Autofabricantes/MYO_ESPControlBoard/02_Elements/MYO_ESPControlBoard_Rev_1/02_HW/eagleUp/eagleUp_MYO_ESPControlBoard_Rev_1_board_bottom.png

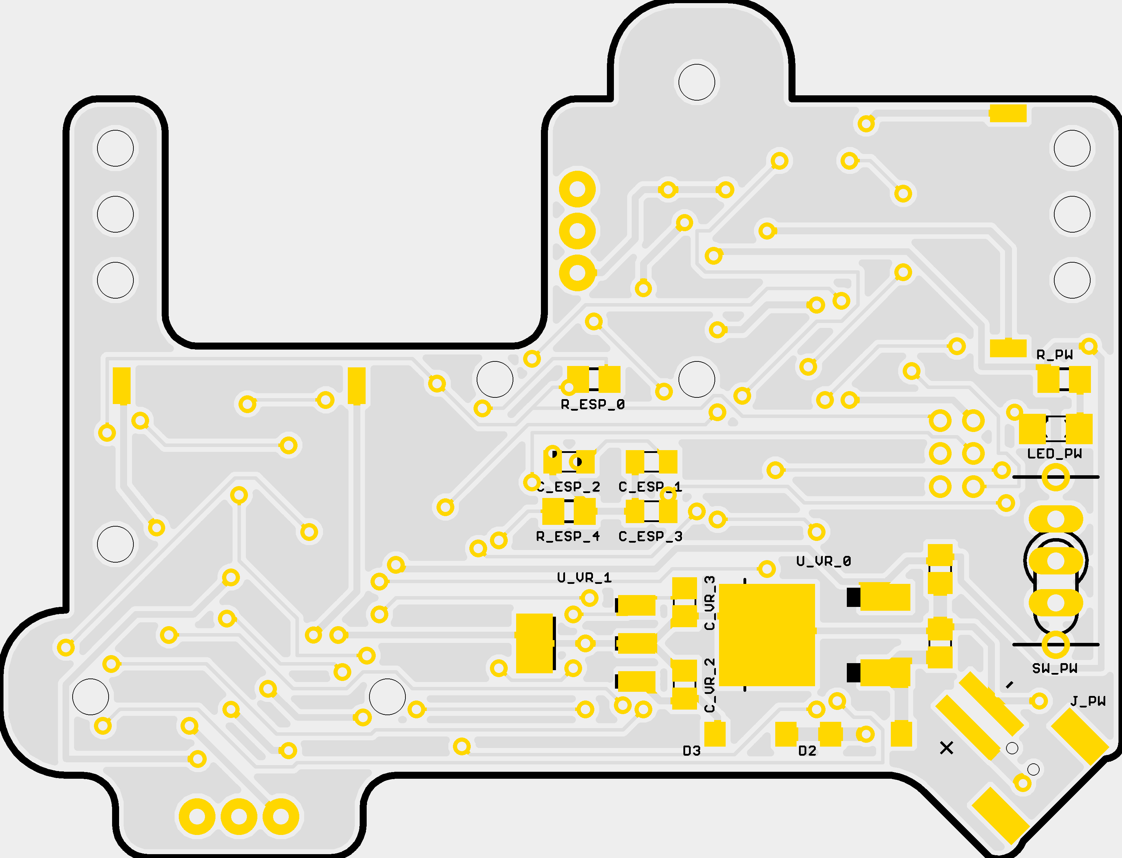
02_Elements/MYO_ESPControlBoard_Rev_1/02_HW/eagleUp/eagleUp_MYO_ESPControlBoard_Rev_1_board_bottom.png
