Autofabricantes/MYO_ESPControlBoard/00_Documentation/Arduino_ESP12F_Tutorial_00.png

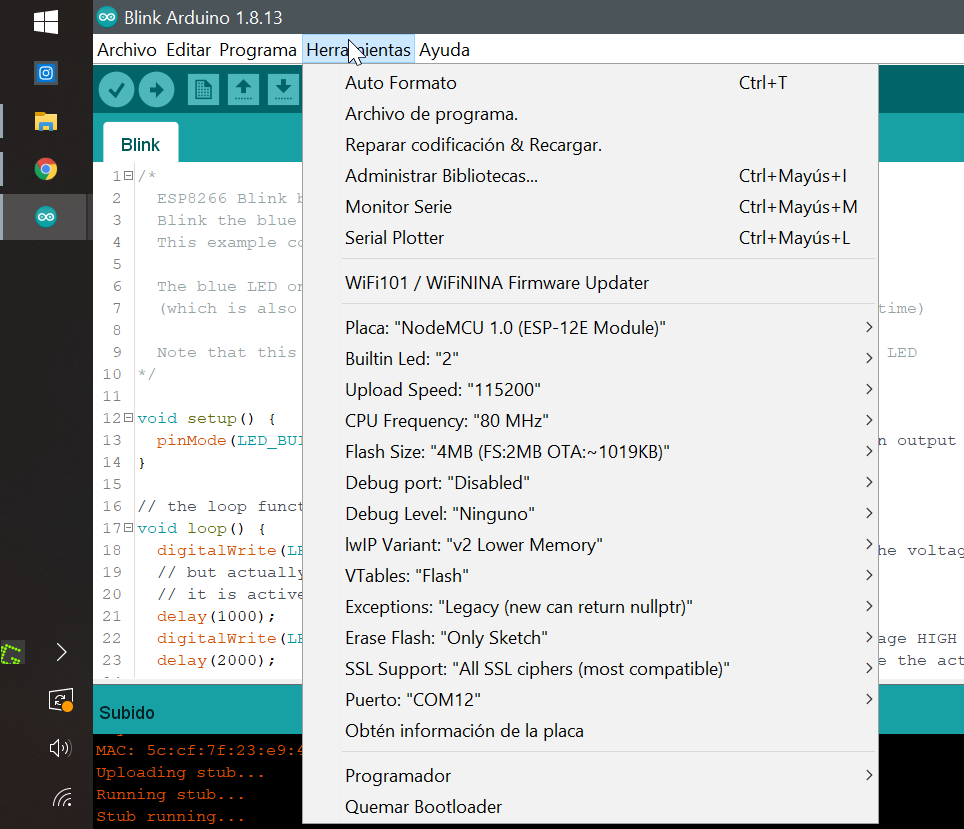
00_Documentation/Arduino_ESP12F_Tutorial_00.png
