Autofabricantes/MYO_ESPControlBoard/02_Elements/MYO_ESPControlBoard_Rev_1/00_Documentation/MYO_ESPControlBoard_Rev_1_Schematic.pdf

# io 0 sup 0 io 0

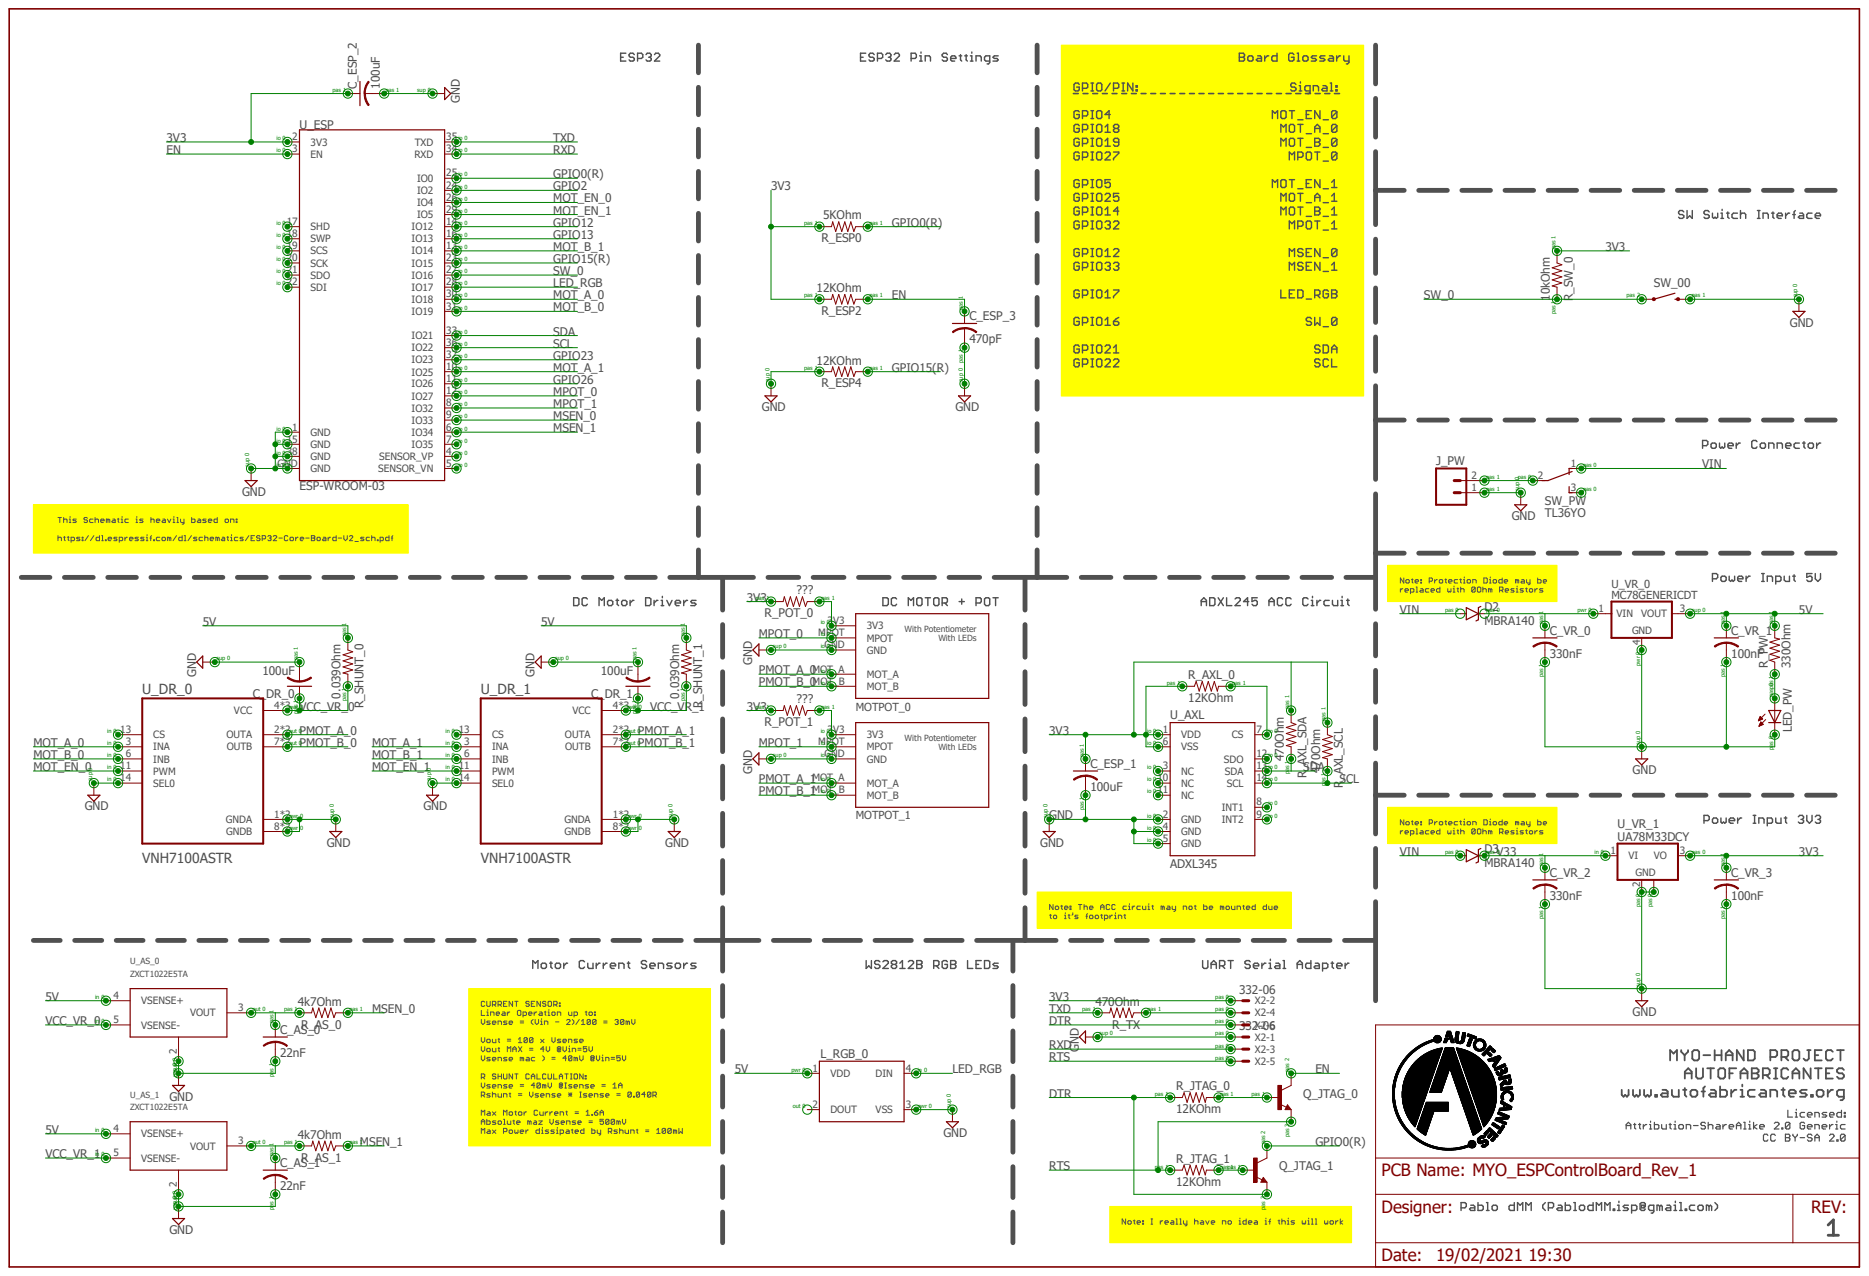
[picture p4: page 1]
330Ohm; GND; ESP-WROOM-03 GND; MC78GENERICDT GND GND; UA78M33DCY; MBRA140; 5KOhm; 12KOhm; GND ¹⁰⁰uF; 470pF GND; ADXL345; 470Ohm; GND TL36YO; VNH7100ASTR; 4k7Ohm; 22nF ZXCT1022E5TA GND; 0.039Ohm; GND ¹⁰kOhm; 332-06 GND 470Ohm; LED_PW R_PW; GND 1; SENSOR_VP; 4 SENSOR_VN; 14 GND 15; 16 SHD 17; SWP 18; SCS 19; GND 38; TXD; 35 RXD; SDI 22; SDO 21; SCK 20; GND GND; U_ESP; VIN 1 4 VOUT; 3V3 3V3 MPOT MPOT GND GND; MOT_A MOT_A MOT_B MOT_B; MOTPOT_0With Potentiometer With LEDs 3V3 3V3; MPOT MPOT GND GND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
