Autofabricantes/MYO_ESPControlBoard/00_Documentation/MYO_ESPControlBoard_Rev_1_Propuesta_01.pdf

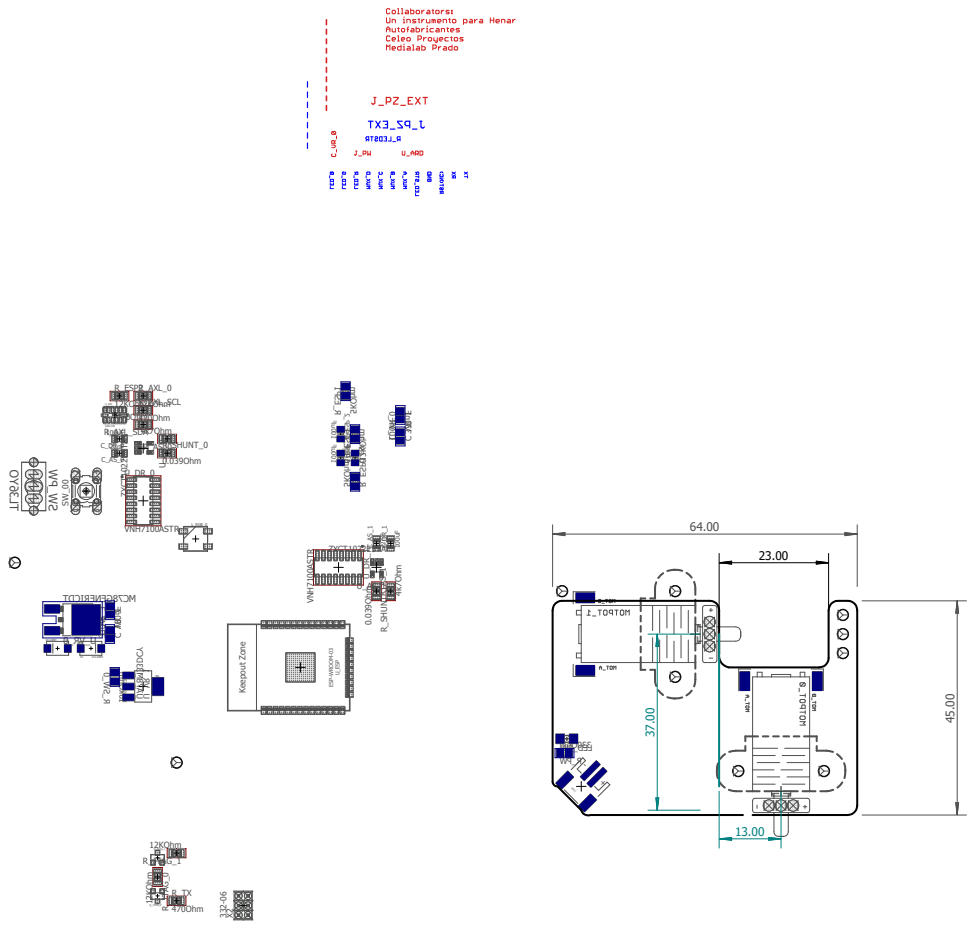
[picture p5: page 1]
R_ESP2; L_RGB_0; U_AXL R_AXL_SDA; R_AXL_SCL; R_AXL_0; U_AS_0R_SHUNT_0; R_SHUNT_1R_AS_1 C_AS_1; Q_JTAG_1; Q_JTAG_0 R_JTAG_1 R_JTAG_0; ESP⁻WROOM⁻⁰³; 12KOhm ADXL345 470Ohm470Ohm; 12KOhm; VNH7100ASTR; VNH⁷¹⁰⁰ASTR; 4k7Ohm; 22nF ZXCT1022E5TA; 0.039Ohm; 4k7Ohm ²²nF ZXCT1022E5TA; 12KOhm 12KOhm; 332⁻06 470Ohm
