Autofabricantes/MYO_ESPControlBoard/02_Elements/MYO_ESPControlBoard_Rev_1/00_Documentation/MYO_ESPControlBoard_Rev_1_Dimensions.pdf

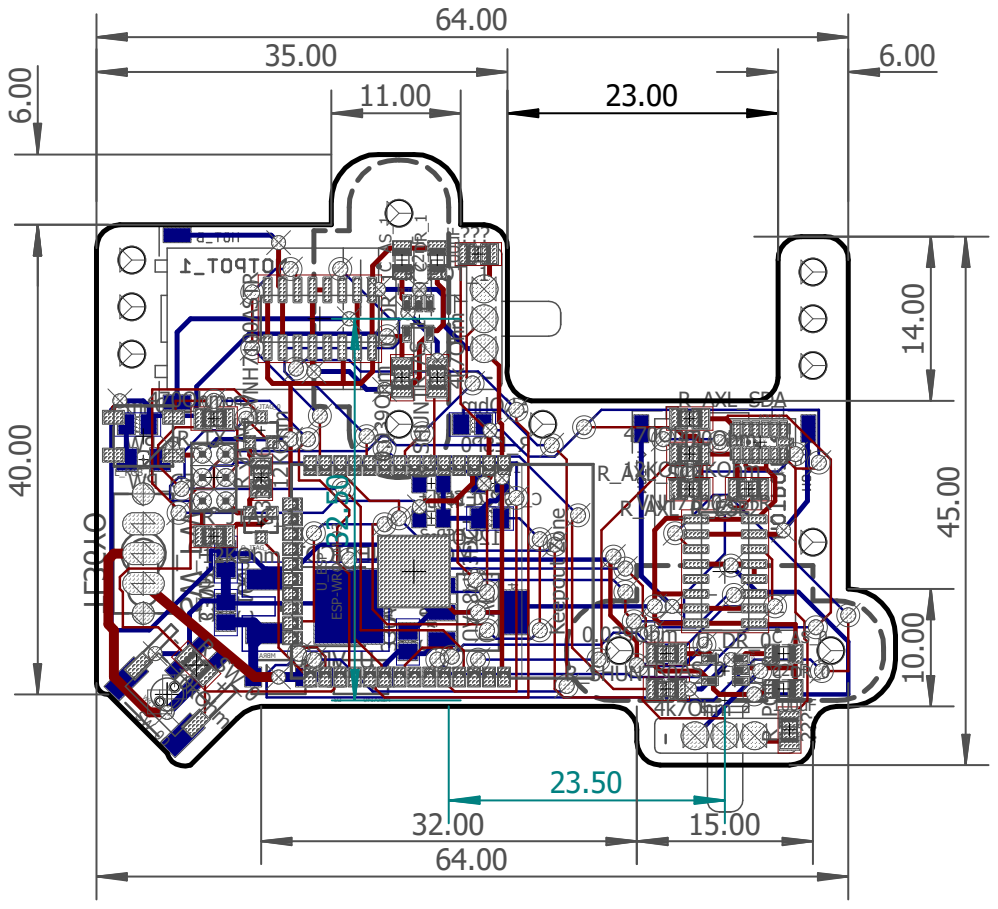
[picture p6: page 1]
1 2Keepout Zone; X Y Z U_ESP; R_ESP2; L_RGB_0; U_AXL R_AXL_SDA; R_AXL_SCL R_AXL_0; C_AS_0 R_SHUNT_0; U_AS_0 R_SHUNT_1R_AS_1 C_AS_1; Q_JTAG_1; Q_JTAG_0 R_JTAG_1 R_JTAG_0 X2R_TX; SW_00 R_POT_0; 12KOhm; ADXL345 470Ohm470Ohm; 12KOhm VNH7100ASTR; 100uF VNH⁷¹⁰⁰ASTR; 4k7Ohm; 22nF ZXCT1022E5TA; 0.039Ohm ⁰.039Ohm; 4k7Ohm ²²nF; ZXCT1022E5TA 10kOhm; 12KOhm ¹²KOhm 332⁻06; 470Ohm

R_POT_1 ESP⁻WROOM⁻⁰³
