Autofabricantes/MYO_ESPControlBoard/01_Resources/esp32-devkitc-v4_reference_design/ESP32-DevKitC-V4_Reference_Design/02_PCB Layout/ESP32-DevKitC-V4_PCB_20171206A.pdf

D1D¹x1 D¹x2 J2J2x1 J2x2 J2x3 J2x4 J2x5 J2x6 J2x7 J2x8 J2x9 J2x10 J2x11 J2x12 J2x13 J2x14 J2x15 J2x16 J2x17 J2x18 J2x19

J3J3x1 J3x2 J3x3 J3x4 J3x5 J3x6 J3x7 J3x8 J3x9 J3x10 J3x11 J3x12 J3x13 J3x14 J3x15 J3x16 J3x17 J3x18 J3x19

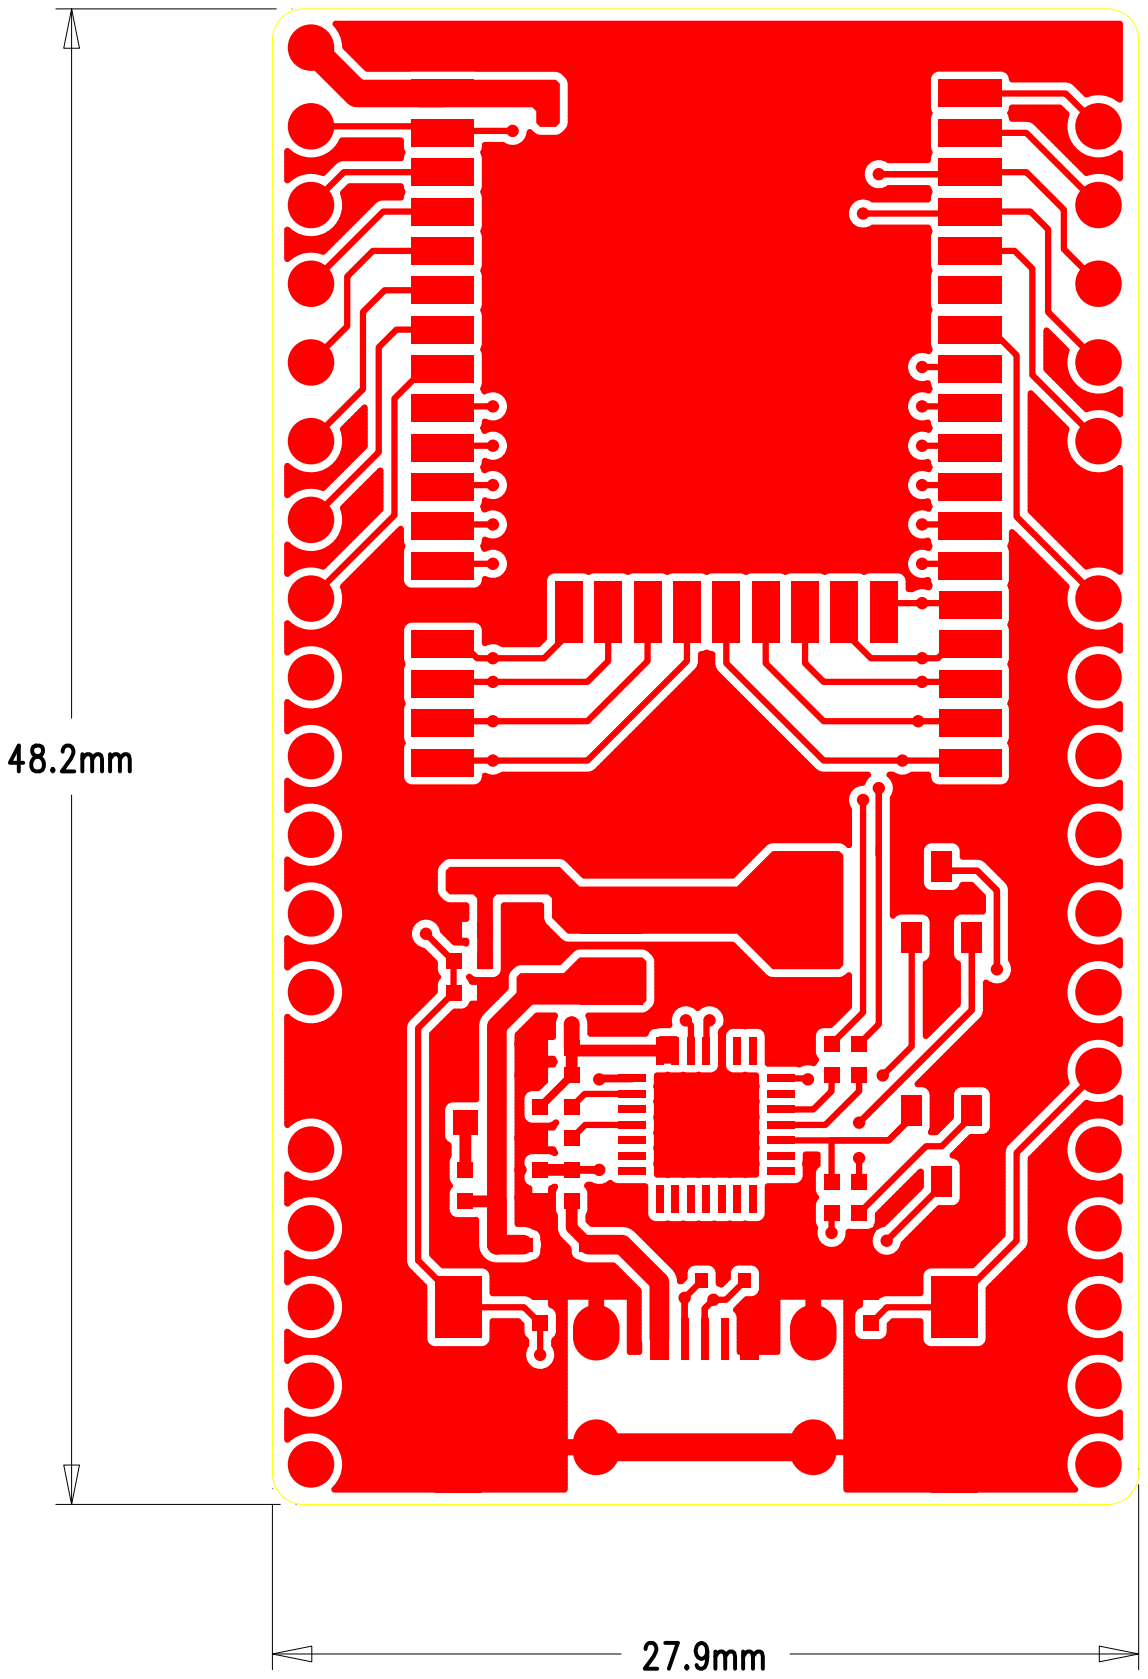
[picture p7: page 1]
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

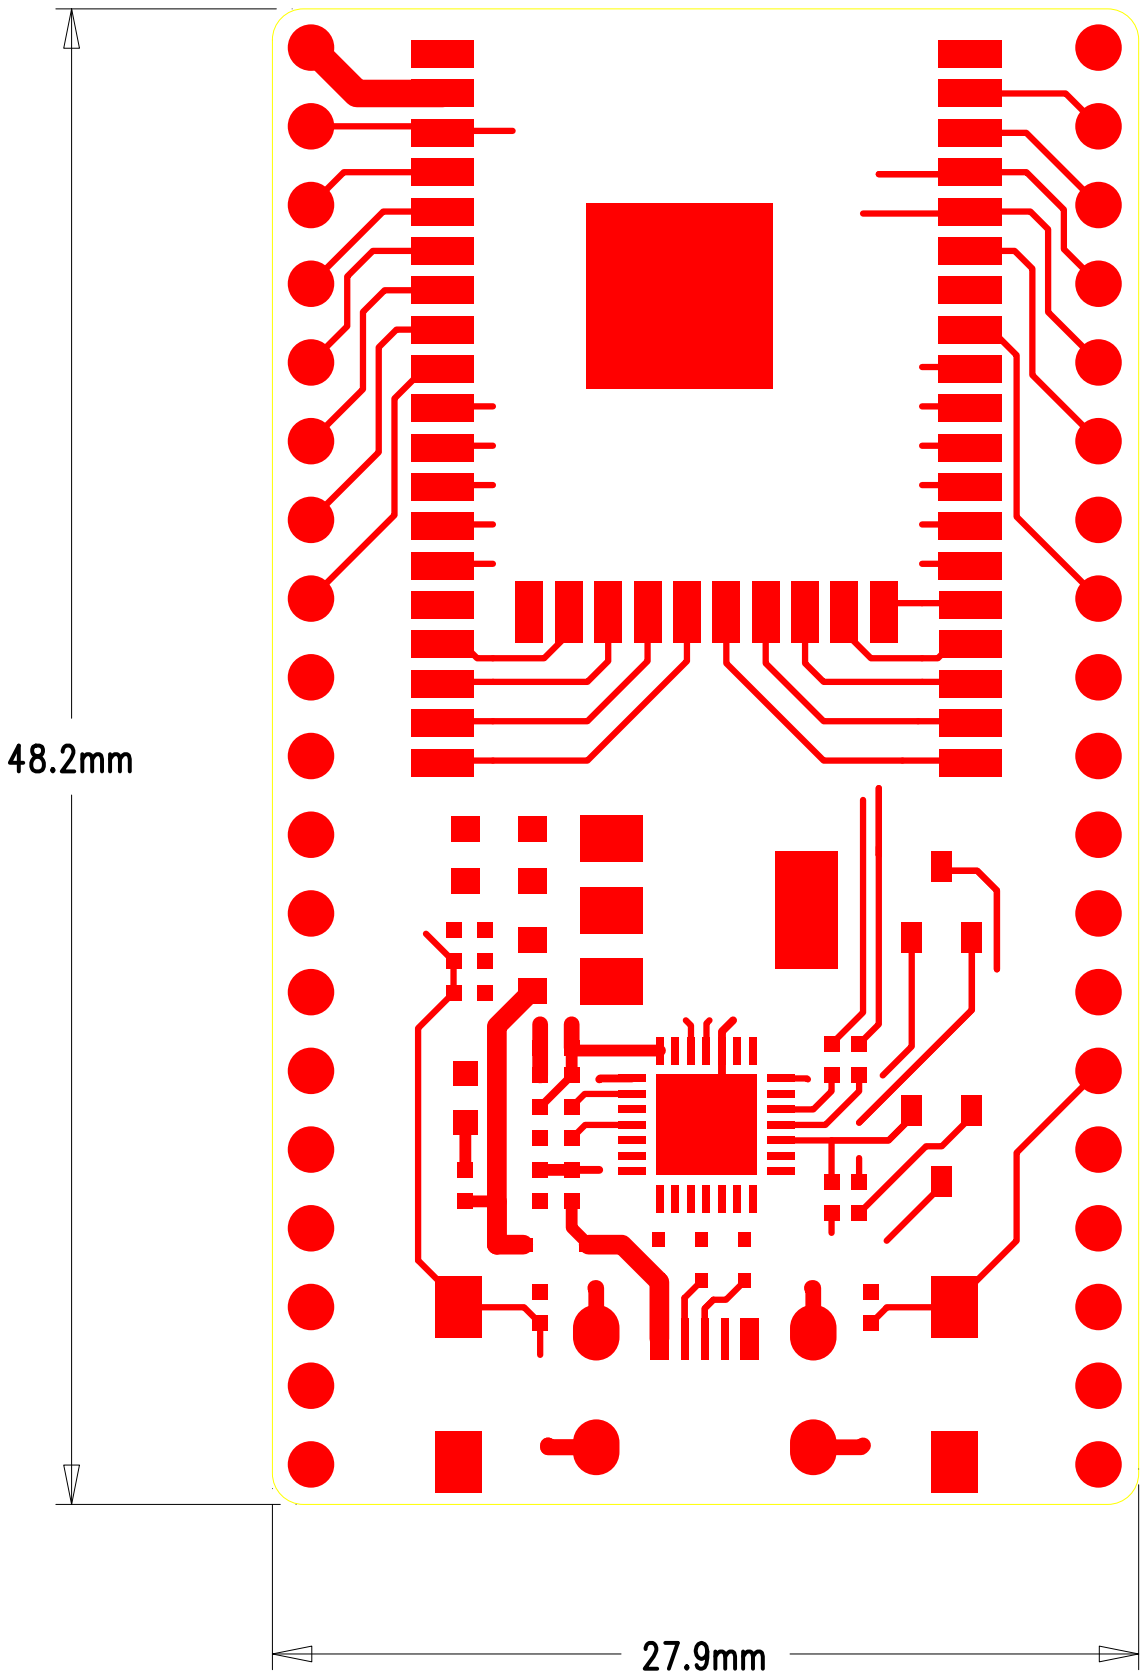
[picture p8: page 2]
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

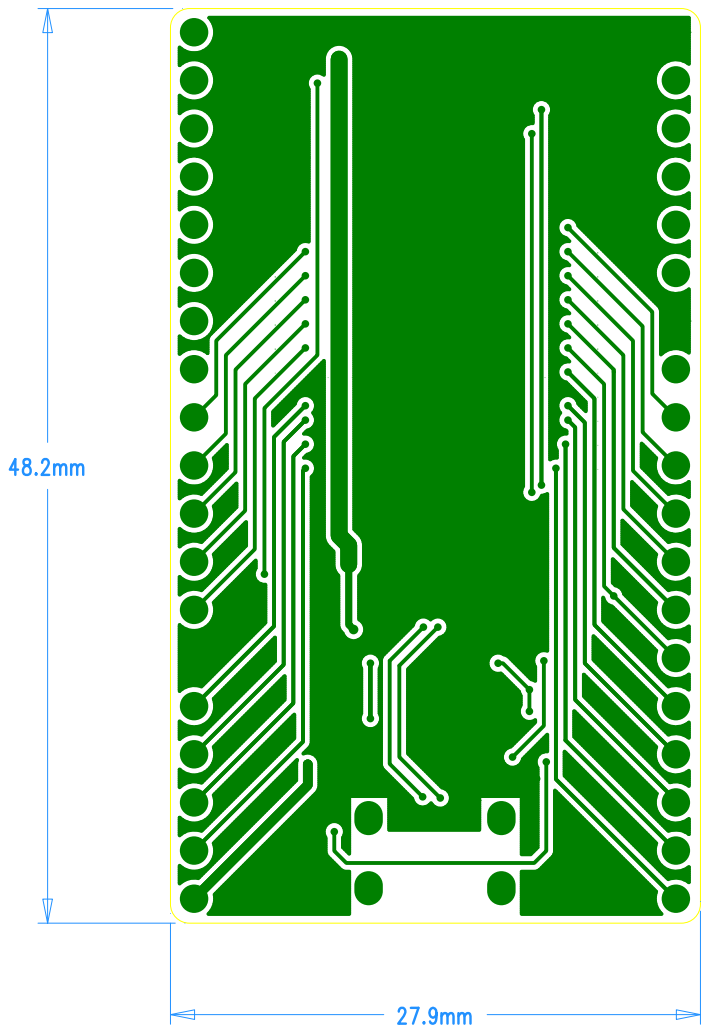
[picture p9: page 3]
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

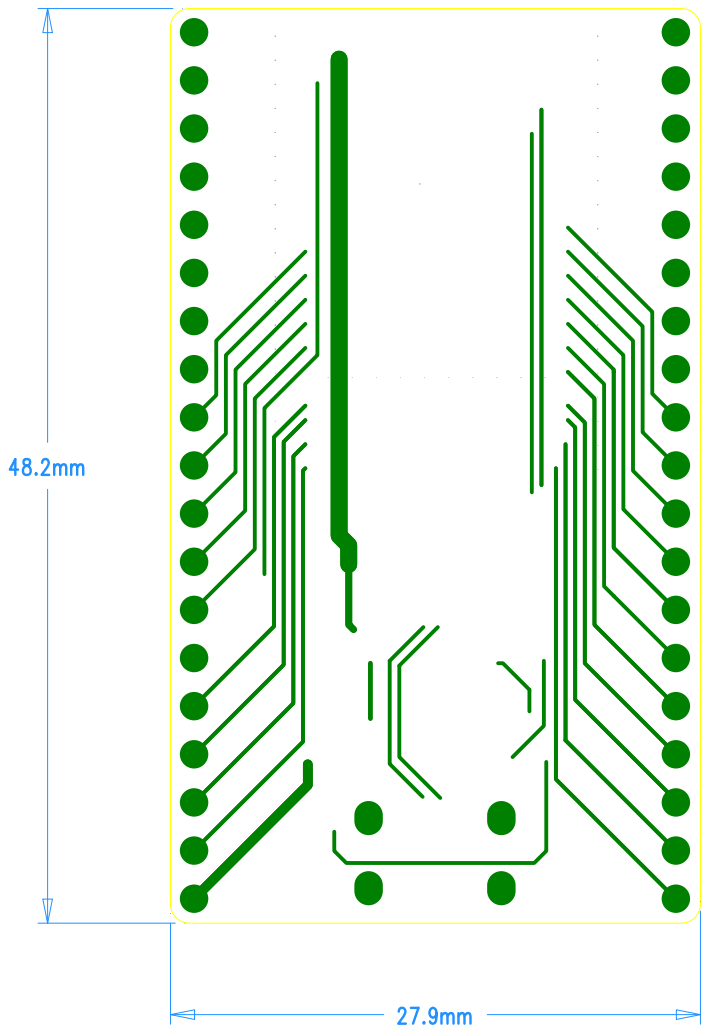
[picture p10: page 4]

# RF Antenna

D2

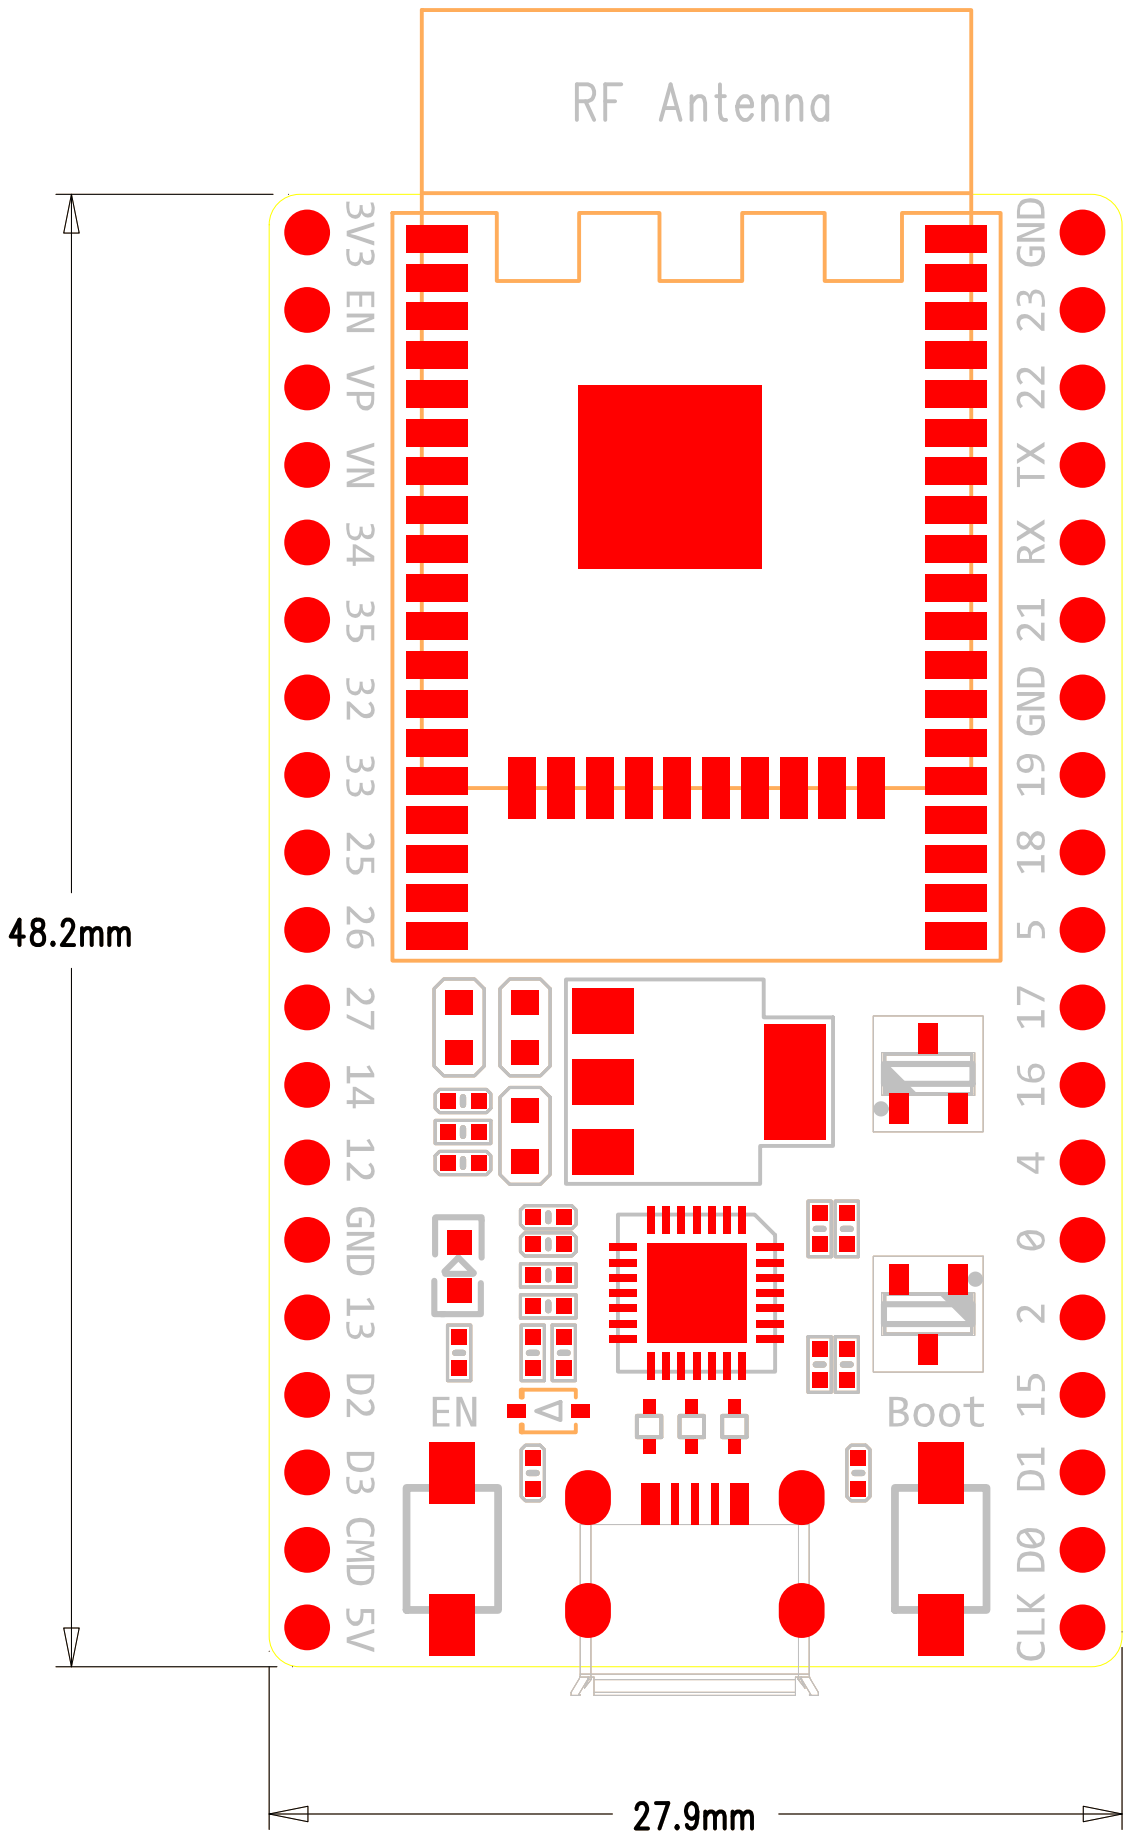
[picture p11: page 5]

3V3 EN VP VN 34 35 32 33 25 26 27 14 12 CMD 13 D2 D3 5V

GND 22 TX RX 21 GND 19 18 16 5 17 4 0 2 15 23 CLK D0 D1

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

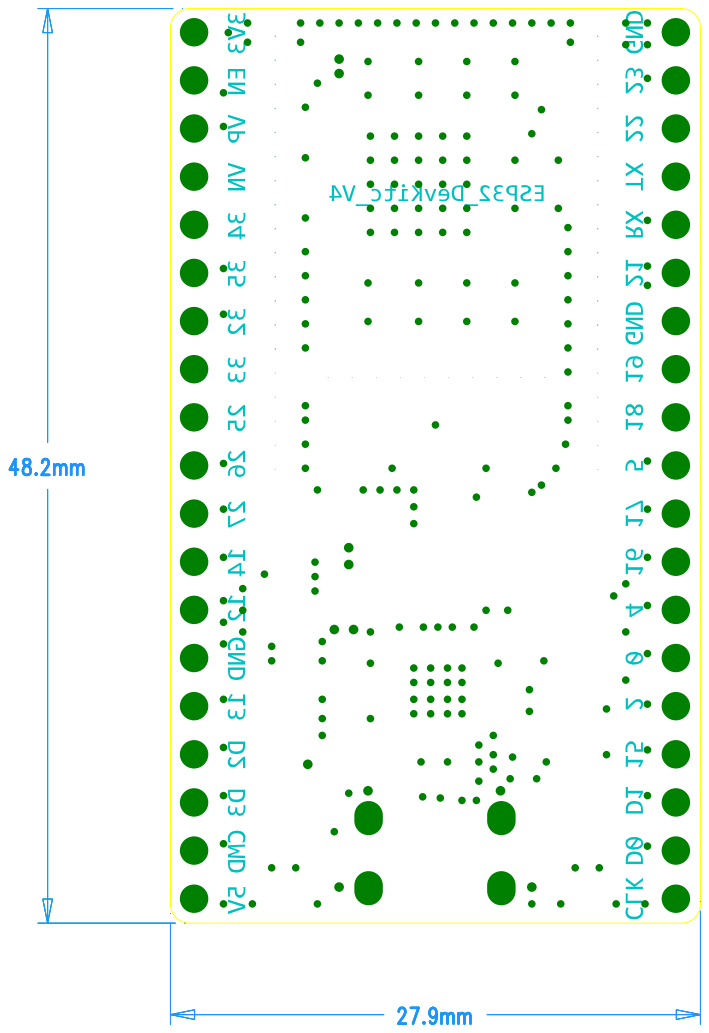
[picture p12: page 6]

3V3 EN VP VN 34 35 32 33 25 26 27 14 12 GND 13 D2 D3 CMD 5V

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
