Autofabricantes/MYO_ESPControlBoard/00_Documentation/MYO_ESPControlBoard_Rev_1_MotorFootprint.pdf

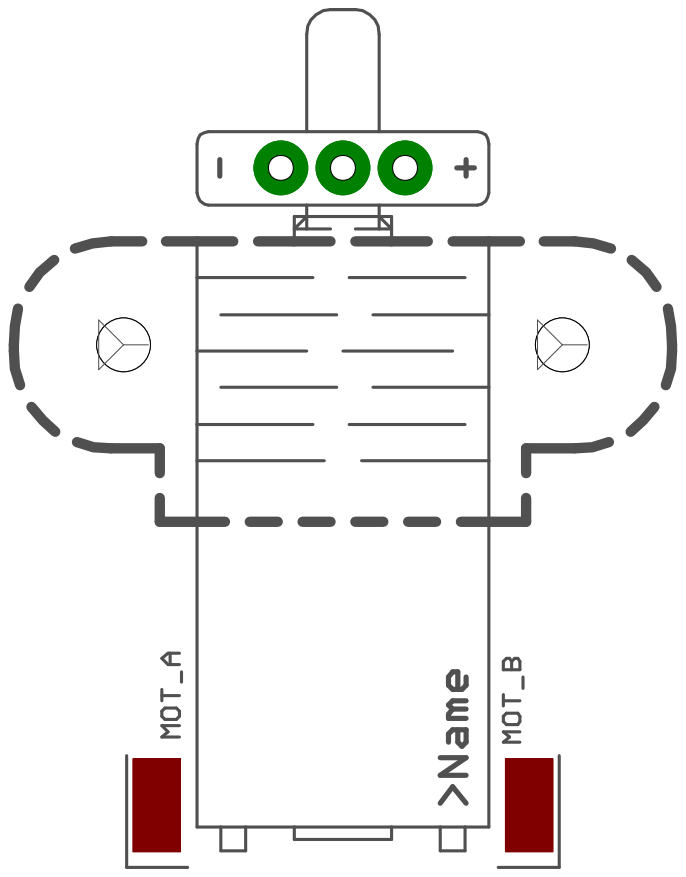
[picture p13: page 1]
