Autofabricantes/MYO_ESPControlBoard/02_Elements/MYO_ESPControlBoard_Rev_1/02_HW/MYO_ESPControlBoard_Rev_1.brd

## EAGLE design 02_Elements/MYO_ESPControlBoard_Rev_1/02_HW/MYO_ESPControlBoard_Rev_1.brd (2021-04-03)

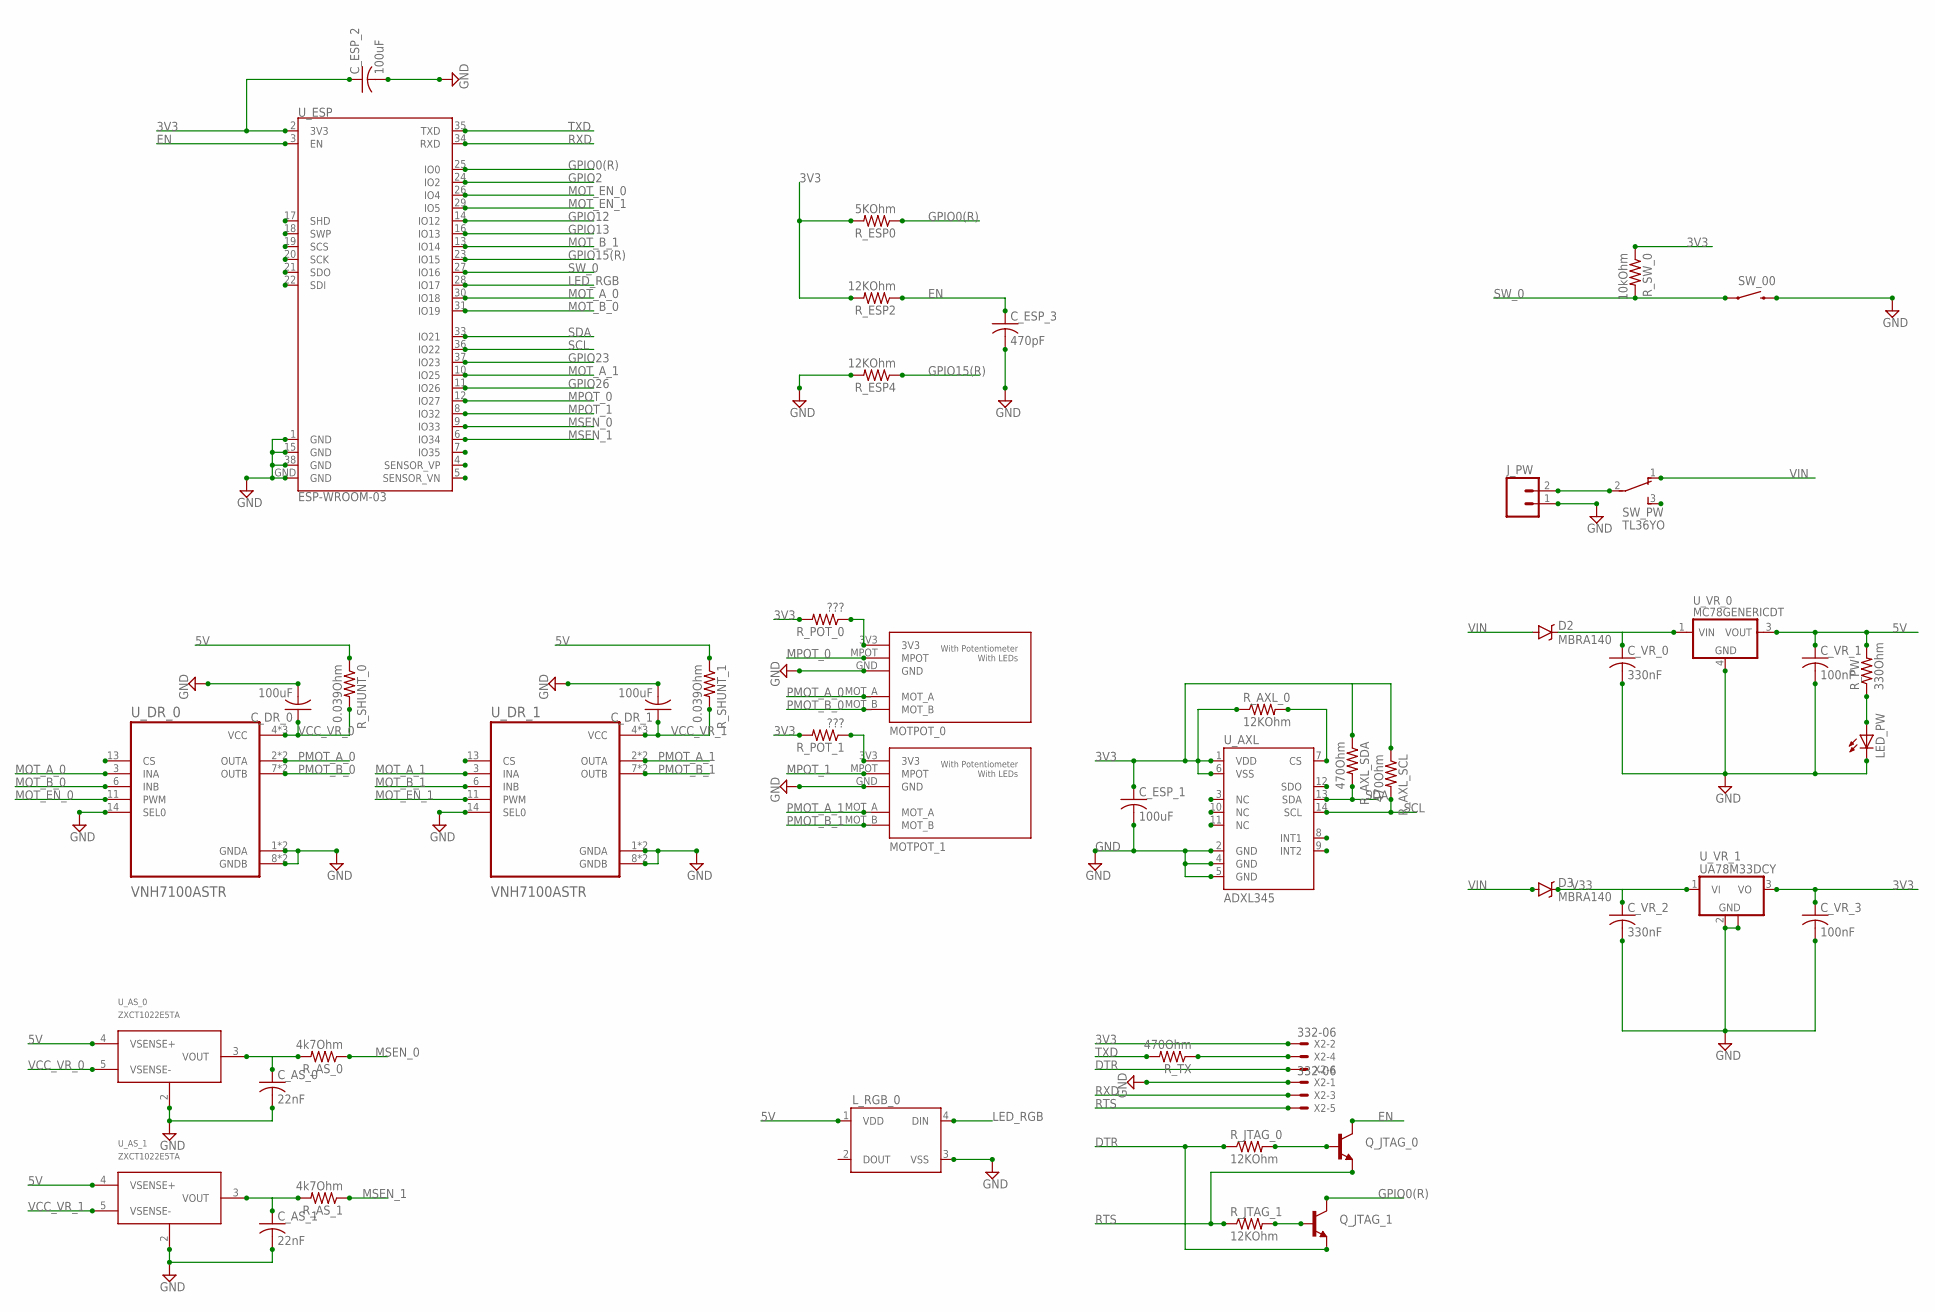
[picture p14: schematic MYO_ESPControlBoard_Rev_1.sch]

Parts:
C_AS_0, C_AS_1: 22nF; C0805K
C_DR_0, C_DR_1: 100uF; C0805K
C_ESP_1, C_ESP_2: 100uF; C0805K
C_ESP_3: 470pF; C0805K
C_VR_0, C_VR_2: 330nF; C0805
C_VR_1, C_VR_3: 100nF; C0805
D2, D3: MBRA140; SMA-DIODE
J_PW: M02-JST-2MM-SMT; JST-2-SMD
LED_PW: LEDSMT1206; 1206
L_RGB_0: WS2812B
MOTPOT_0, MOTPOT_1: POLOLU_MOT_POT
Q_JTAG_0, Q_JTAG_1: TRANSISTOR_NPNSOT23-3; SOT23-3
R_AS_0, R_AS_1: 4k7Ohm; M0805
R_AXL_0: 12KOhm; M0805
R_AXL_SCL: 470Ohm; M0805
R_AXL_SDA: 470Ohm; M0805
R_ESP0: 5KOhm; M0805
R_ESP2, R_ESP4: 12KOhm; M0805
R_JTAG_0, R_JTAG_1: 12KOhm; M0805
R_POT_0, R_POT_1: ???; M0805
R_PW: 330Ohm; M0805
R_SHUNT_0, R_SHUNT_1: 0.039Ohm; M0805
R_SW_0: 10kOhm; M0805
R_TX: 470Ohm; M0805
SW_00: SWITCH-MOMENTARY-2TACTILE-SWITCH-SMD-RIGHT-ANGLE; TACTILE_SWITCH-SMD-RIGHT-ANGLE
SW_PW: TL36YO; TL3XYO
U_AS_0, U_AS_1: ZXCT1022E5TA; SOT95P270X145-5N(SOT23-5)
U_AXL: ADXL345; LGA14
U_DR_0, U_DR_1: VNH7100ASTR; SOIC127P600X175-16N
U_ESP: ESP-WROOM-03
U_VR_0: MC78GENERICDT; DPAK-3
U_VR_1: UA78M33DCY; SOT223
X2: 332-06

Connections:
3V3: C_ESP_1.1, C_ESP_2.1, C_VR_3.1, R_AXL_0.1, R_AXL_SCL.1, R_AXL_SDA.1, R_ESP0.2, R_ESP2.2, R_POT_0.2, R_POT_1.2, R_SW_0.1, U_AXL.1 (VDD), U_AXL.6 (VSS), U_ESP.2 (3V3), U_VR_1.3 (VO), X2.2
5V: C_VR_1.1, L_RGB_0.1 (VDD), R_PW.2, R_SHUNT_0.1, R_SHUNT_1.1, U_AS_0.4 (VSENSE+), U_AS_1.4 (VSENSE+), U_VR_0.3 (VOUT)
DTR: Q_JTAG_1.2 (E), R_JTAG_0.1, X2.6
EN: C_ESP_3.1, Q_JTAG_0.3 (C), R_ESP2.1, U_ESP.3 (EN)
GND: C_AS_0.2, C_AS_1.2, C_DR_0.2, C_DR_1.2, C_ESP_1.2, C_ESP_2.2, C_ESP_3.2, C_VR_0.2, C_VR_1.2, C_VR_2.2, C_VR_3.2, J_PW.1, LED_PW.C, L_RGB_0.3 (VSS), MOTPOT_0.GND, MOTPOT_1.GND, R_ESP4.2, SW_00.2, U_AS_0.2 (GND), U_AS_1.2 (GND), U_AXL.2 (GND), U_AXL.4 (GND), U_AXL.5 (GND), U_DR_0.1 (GNDA), U_DR_0.8 (GNDB), U_DR_0.9 (GNDB), U_DR_0.14 (SEL0), U_DR_0.16 (GNDA), U_DR_1.1 (GNDA), U_DR_1.8 (GNDB), U_DR_1.9 (GNDB), U_DR_1.14 (SEL0), U_DR_1.16 (GNDA), U_ESP.1 (GND), U_ESP.15 (GND), U_ESP.38 (GND), U_ESP.GND, U_VR_0.4 (GND), U_VR_1.2 (GND), U_VR_1.4 (GND), X2.1
GPIO0(R): Q_JTAG_1.3 (C), R_ESP0.1, U_ESP.25 (IO0)
GPIO2: U_ESP.24 (IO2)
GPIO12: U_ESP.14 (IO12)
GPIO13: U_ESP.16 (IO13)
GPIO15(R): R_ESP4.1, U_ESP.23 (IO15)
GPIO23: U_ESP.37 (IO23)
GPIO26: U_ESP.11 (IO26)
LED_RGB: L_RGB_0.4 (DIN), U_ESP.28 (IO17)
MOT_A_0: U_DR_0.3 (INA), U_ESP.30 (IO18)
MOT_A_1: U_DR_1.3 (INA), U_ESP.10 (IO25)
MOT_B_0: U_DR_0.6 (INB), U_ESP.31 (IO19)
MOT_B_1: U_DR_1.6 (INB), U_ESP.13 (IO14)
MOT_EN_0: U_DR_0.11 (PWM), U_ESP.26 (IO4)
MOT_EN_1: U_DR_1.11 (PWM), U_ESP.29 (IO5)
MPOT_0: MOTPOT_0.MPOT, U_ESP.12 (IO27)
MPOT_1: MOTPOT_1.MPOT, U_ESP.8 (IO32)
MSEN_0: R_AS_0.1, U_ESP.9 (IO33)
MSEN_1: R_AS_1.1, U_ESP.6 (IO34)
unnamed: MOTPOT_0.3V3, R_POT_0.1
unnamed: MOTPOT_1.3V3, R_POT_1.1
unnamed: Q_JTAG_0.1 (B), R_JTAG_0.2
unnamed: LED_PW.A, R_PW.1
unnamed: Q_JTAG_1.1 (B), R_JTAG_1.2
unnamed: R_TX.1, X2.4
unnamed: C_AS_0.1, R_AS_0.2, U_AS_0.3 (VOUT)
unnamed: R_AXL_0.2, U_AXL.7 (CS)
unnamed: J_PW.2, SW_PW.2
unnamed: C_AS_1.1, R_AS_1.2, U_AS_1.3 (VOUT)
PMOT_A_0: MOTPOT_0.MOT_A, U_DR_0.2 (OUTA), U_DR_0.15 (OUTA)
PMOT_A_1: MOTPOT_1.MOT_A, U_DR_1.2 (OUTA), U_DR_1.15 (OUTA)
PMOT_B_0: MOTPOT_0.MOT_B, U_DR_0.7 (OUTB), U_DR_0.10 (OUTB)
PMOT_B_1: MOTPOT_1.MOT_B, U_DR_1.7 (OUTB), U_DR_1.10 (OUTB)
RTS: Q_JTAG_0.2 (E), R_JTAG_1.1, X2.5
RXD: U_ESP.34 (RXD), X2.3
SCL: R_AXL_SCL.2, U_AXL.14 (SCL), U_ESP.36 (IO22)
SDA: R_AXL_SDA.2, U_AXL.13 (SDA), U_ESP.33 (IO21)
SW_0: R_SW_0.2, SW_00.1, U_ESP.27 (IO16)
TXD: R_TX.2, U_ESP.35 (TXD)
V5: C_VR_0.1, D2.C, U_VR_0.1 (VIN)
V33: C_VR_2.1, D3.C, U_VR_1.1 (VI)
VCC_VR_0: C_DR_0.1, R_SHUNT_0.2, U_AS_0.5 (VSENSE-), U_DR_0.4 (VCC), U_DR_0.5 (VCC), U_DR_0.12 (VCC)
VCC_VR_1: C_DR_1.1, R_SHUNT_1.2, U_AS_1.5 (VSENSE-), U_DR_1.4 (VCC), U_DR_1.5 (VCC), U_DR_1.12 (VCC)
VIN: D2.A, D3.A, SW_PW.1 (O)

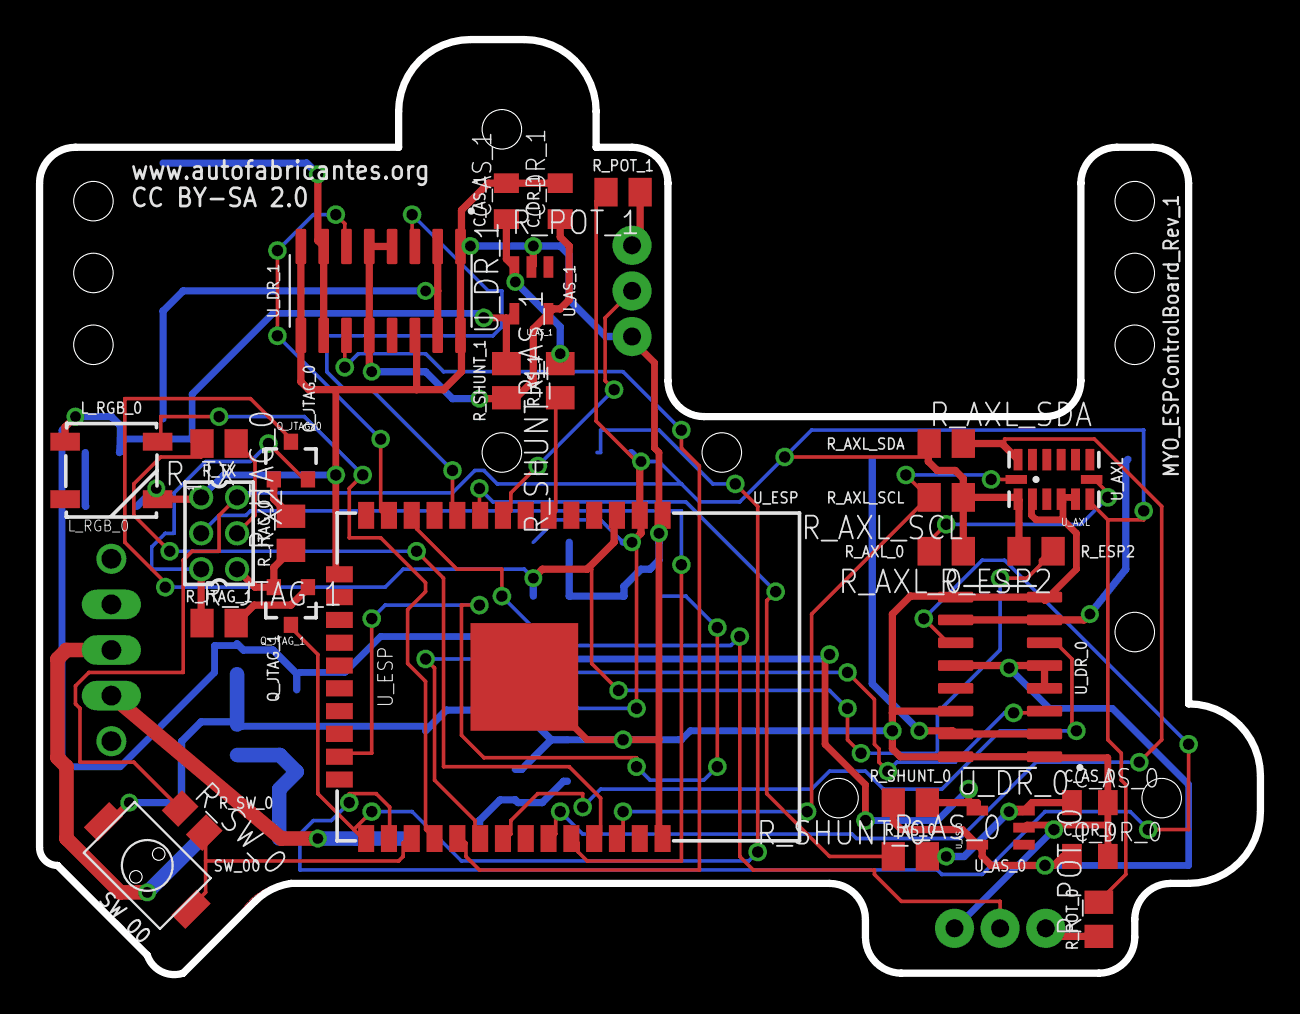
[picture p15: board MYO_ESPControlBoard_Rev_1.brd from above]

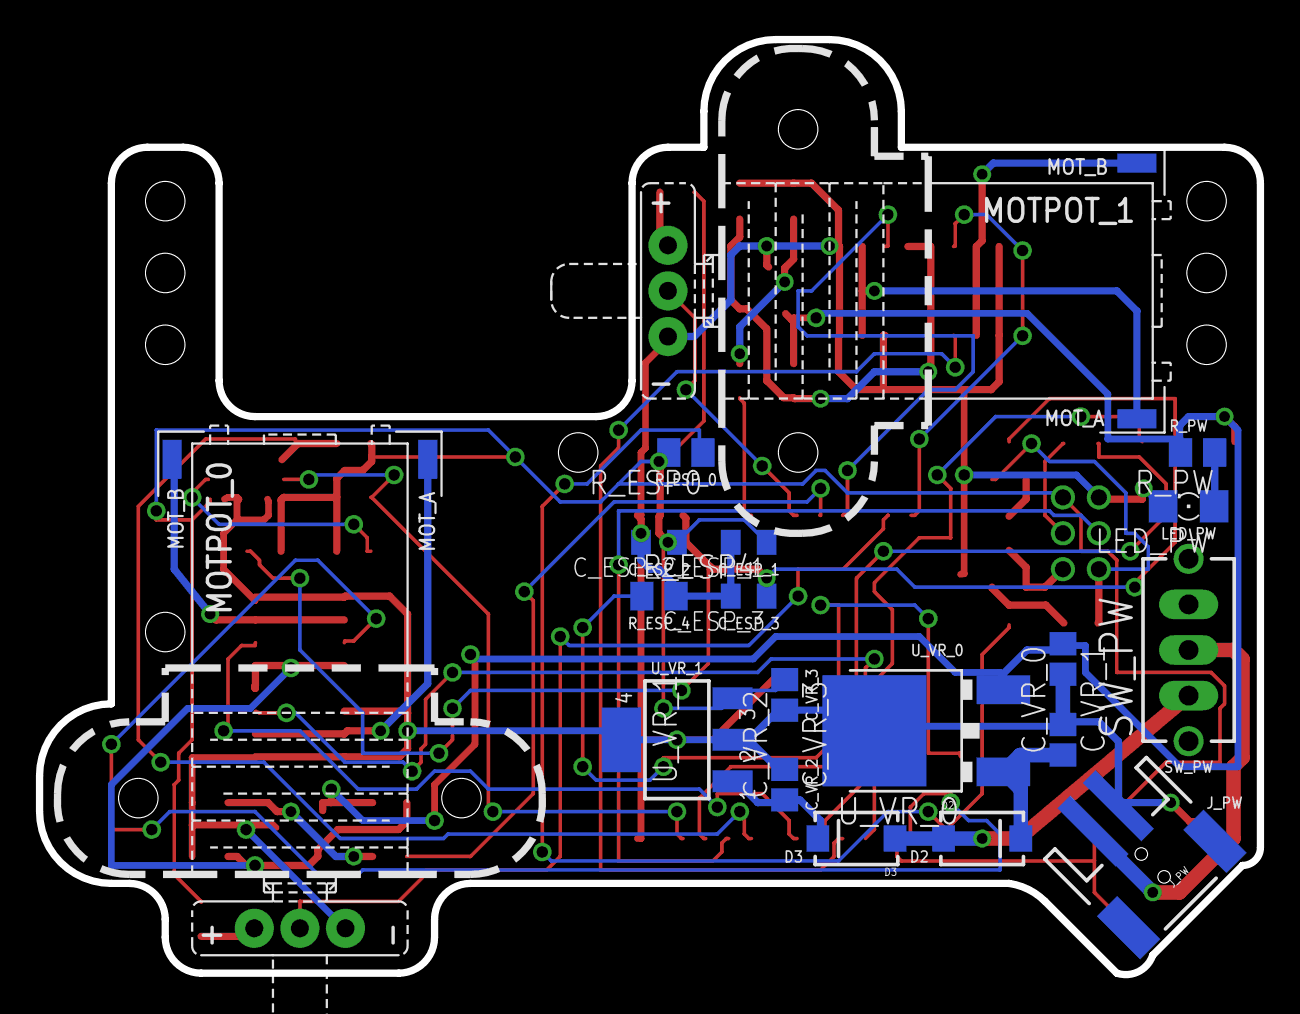
[picture p16: board MYO_ESPControlBoard_Rev_1.brd from below]

Board: 2 copper layers, 68.0 x 52.1 mm, 48 parts (19 on the bottom side), 43 nets.
