Autofabricantes/MYO_ESPControlBoard/02_Elements/MYO_ESPControlBoard_Rev_1/03_SW/ESP32_Controller/src/main.cpp

#include <Arduino.h>

// My libraries
#include "Constants.h"
#include "InputOutputUtils.h"
#include "Test.h"
#include "MyoOTA.h"

// Constants
int counter = 0;
InputOutputUtils inputOutputUtils;
Test tester;
MyoOTA myoOTA;

// Ejecución del Webserver para la carga del .bin
// http://192.168.1.135/
void handleWebServer(){

  log_i("OTA Web Server running (Port %d)", xPortGetCoreID());

  log_i("Time to load...");
  int counter = 60;

  while(counter > 0){
    counter--;
    log_i("Countdown %d", counter);
    myoOTA.handleClient();
    vTaskDelay(1000);
  }

}

void setup() {

  // Start serial interface for debugging
  Serial.begin(115200);       

  log_i(">> Setup .......");

  // OTA handling
  // myoOTA.startOTA();
  // handleWebServer();

  // Setting  execution mode
  log_i("Execution mode: %i", mode);
  if(mode == TEST_MODE_MYO_EMG_OUTPUT || mode == TEST_MODE_MYO_STATES  || mode == OPERATION_MODE){
	    inputOutputUtils.initIO();
      inputOutputUtils.connectMyo();
  }else if(mode ==  TEST_MODE_BOARD || TEST_MODE_TRANSITIONS){
      inputOutputUtils.initIO();
  }
  if(TEST_MODE_BOARD){
      tester.setIoUtils(&inputOutputUtils);
  }

}

void loop() {

  counter++;
  log_i("Myo running (loop %i)", counter);
  
  if(mode == TEST_MODE_BOARD){
    tester.testingBoard();
  }else if(mode == TEST_MODE_TRANSITIONS){
    inputOutputUtils.executeTransition();
  }else{

    inputOutputUtils.myoUtils.detectDisconnect();

    if(mode == TEST_MODE_MYO_STATES){
      inputOutputUtils.myoUtils.getMyoStateToGet();
    }else if(mode == TEST_MODE_MYO_EMG_OUTPUT){
      inputOutputUtils.myoUtils.getMyoEMG();
    }else if(mode == OPERATION_MODE){
      inputOutputUtils.executeTransition();
    }      
  } 

  vTaskDelay(5000);

}
