Autofabricantes/MYO_ESPControlBoard/02_Elements/MYO_ESPControlBoard_Rev_1/03_SW/ESP32_Controller/include/MyoOTA.h

#ifndef MYO_OTA_H
#define MYO_OTA_H

#include "Constants.h"

// Threading
#include <pthread.h>

// OTA LIbraries
#include <WiFi.h>
#include <WiFiClient.h>
#include <WebServer.h>
#include <ESPmDNS.h>
#include <Update.h>


class MyoOTA {
        
	public:
	
		void startOTA();
		void handleClient();
		
	private:

		pthread_t webServerThread;
		static void * runServer(void * threadId);
    
};

#endif
