Autofabricantes/MYO_ESPControlBoard/(commit log)

2018-12-01 Beginning of Schematic Design
    Just temporary backup with circuits:
    - ESP32
    - Serial USB Comm
    [MLP_ESPControlBoard_Rev_1.brd, MLP_ESPControlBoard_Rev_1.sch]
2019-01-23 Schematic Update
    Advanced Schematic, not final
    [MLP_ESPControlBoard_Rev_1.brd, MLP_ESPControlBoard_Rev_1.sch]
2019-01-30 MYO_ESPControlBoard_Rev_1 Schematic completed
    Upload of the MYO_ESPControlBoard_Rev_1 Schematic to be tested
    [MLP_ESPControlBoard_Rev_1.brd, MLP_ESPControlBoard_Rev_1.sch, MYO_ESPControlBoard_Rev_1.brd, MYO_ESPControlBoard_Rev_1.sch]
2021-01-24 MYO_ESPControlBoard_Rev_1 Draft Update on HW (SCH, BRD and 3D)
    Primary Draft of the PCB Schematic and Layout of MYO_ESPControlBoard_Rev_1, for evaluation:
    - Complete Schematic
    - Draft Layout without Drills or Silk
    - Primary 3D Model
    [MYO_ESPControlBoard_Rev_1.brd, MYO_ESPControlBoard_Rev_1.sch]
2021-02-02 Updated Design with NPN JTAG Programming Interface
    Changed Schematic:
    - Added NPN JTAG Controller (as for https://dl.espressif.com/dl/schematics/ESP32-Core-Board-V2_sch.pdf ). Suppresed 2 Tactile Switches for Programming Interface
    - Added 1 Tactile Switch for User Interface
    - Added Expressiv Documentation
    [ESP32-DevKitC-V4-(ESP32-SOLO-1)-BOMList(V1.2)-20180621A.xlsx, ESP32-DevKitC-V4-(ESP32-WROOM-32)-BOMList(V1.1)-20180607A.xlsx, ESP32-DevKitC-V4-(ESP32-WROOM-32D)-BOMList(V1.1)-20180607A.xlsx, ESP32-DevKitC-V4-(ESP32-WROOM-32U)-BOMList(V1.1)-20180607A.xlsx, ESP32-DevKitC-V4_20171206A.pcb, MYO_ESPControlBoard_Rev_1.brd, MYO_ESPControlBoard_Rev_1.sch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]
2021-02-04 MYO_ESPControlBoard_Rev_1 Schematic Fixed. New Dimensions for Board
    MYO_ESPControlBoard_Rev_1:
    - Schematic Fixed
    - Tactile Switch SW_1 Removed
    - New Dimensions and Board Layout
    Transition Commit, soon to be finished :-)
    [MYO_ESPControlBoard_Rev_1.brd, MYO_ESPControlBoard_Rev_1.sch]
2021-02-09 Updated Schematic and Board
    Safe Bakcup
    [MYO_ESPControlBoard_Rev_1.brd, MYO_ESPControlBoard_Rev_1.sch]
2021-02-19 Updated Dimension and Layout MYO_ESPControlBoard_Rev_1
    Changes on MYO_ESPControlBoard_Rev_1:
    - New Dimensions and Layout
    - Changed Motor + Bracket Footprint
    - Changed User Tactile Switch
    - Added BOM in .txt format
    [MYO_ESPControlBoard_Rev_1.brd, MYO_ESPControlBoard_Rev_1.sch]
2021-02-21 MYO_ESPControlBoard_Rev_1 Final revision and Gerber Files
    - Finished Silk Serigraphy
    - Generated new 3D Model EagleUp ULP
    - Generated Gerber Files
    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
    [MYO_ESPControlBoard_Rev_1.GBL, MYO_ESPControlBoard_Rev_1.GBO, MYO_ESPControlBoard_Rev_1.GBP, MYO_ESPControlBoard_Rev_1.GBS, MYO_ESPControlBoard_Rev_1.GTL, MYO_ESPControlBoard_Rev_1.GTO, MYO_ESPControlBoard_Rev_1.GTP, MYO_ESPControlBoard_Rev_1.GTS]
2021-04-19 Added MYO_ESPControlBoard_Rev_1_BoardTest.ino
    Added MYO_ESPControlBoard_Rev_1_BoardTest.ino with a test SW for the board connections.
2021-06-06 Update. OTA & Threading
2021-09-21 MYO_BLETestController.ino
    Added code to test the board regarding mechanical issues. It covers:
    - BLE Control trhough an Android BLE Terminal (Not IOS pls)
    - MYO_Motor.h for Motor Control
    - MYO_LED.h for RGB LED Control
    TODO:
    - Fix initialization GPIO for MOT_B_1
    - Implement a proper BLE Communication Protocol
    [MYO_BLETestController.ino, MYO_LED.cpp, MYO_LED.h, MYO_Motor.cpp, MYO_Motor.h]
2021-09-21 Corrected MYO_Motor::setDirection()
    That's right! This is good news don't you now?
    [MYO_BLETestController.ino, MYO_Motor.cpp]
2021-10-03 Corrección de errores OTA
    Se había intentado mantener dos hilos simultaneos, uno manteniendo el webserver en pie para la carga del código OTA y otro para la ejecución del código principal, pero terminábamos teniendo un crash en la stack. Se aplica una solución más sencilla dando tras el reboot de la placa la posibilidad de cargar código nuevo. Se puede tomar como referencia el código eliminado si necesitamos más adelante el uso de threads.
    [custom.csv]
2022-08-26 Update with BOM and correct Pinout
    Update with BOM and correct Pinout due to ESP32 GPIO14 PWM during boot.
    [MYO_BLETestController.ino, MYO_Motor.cpp]
