Autofabricantes/MYO_ESPControlBoard/(notices)

Notices in the files:
02_Elements/MYO_ESPControlBoard_Rev_1/02_HW/MYO_ESPControlBoard_Rev_1.sch:
CC BY-SA 2.0
parts and their libraries:
SparkFun: Licensing: CC v3.0 Share-Alike You are welcome to use this library for commercial purposes.
SparkFun-DiscreteSemi: Licensing: Creative Commons ShareAlike 4.0 International - https://creativecommons.org/licenses/by-sa/4.0
